AMAVILANH/DinaMonkey/Informe/simulaciones_fea.png

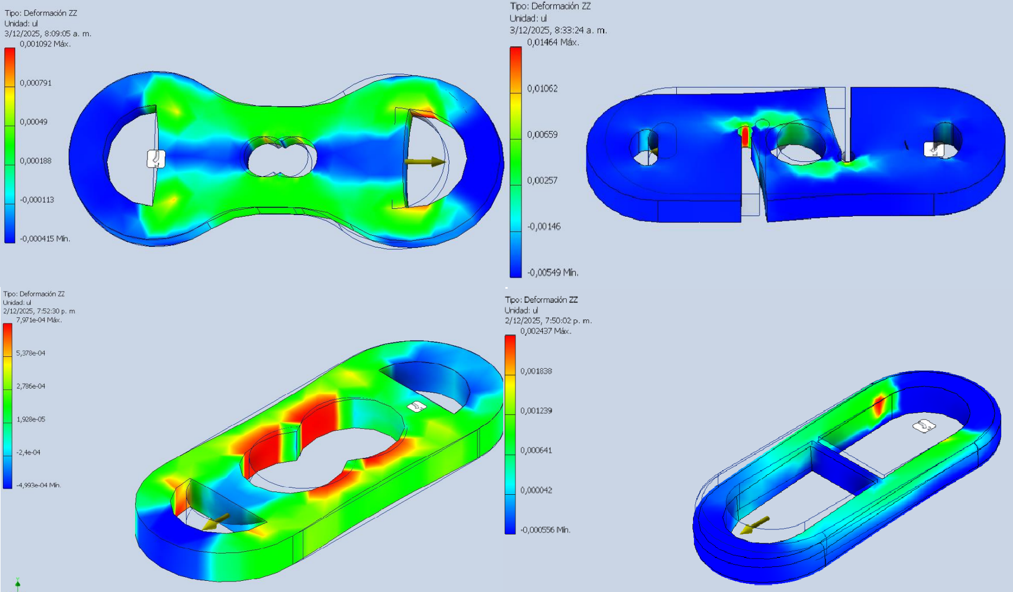
Informe/simulaciones_fea.png
