AMAVILANH/DinaMonkey/README.md

# DinaMonkey
Design and implementation of an embedded dynamometer using strain gauges for force measurement, amplification, digital acquisition, and experimental calibration.
