AMAVILANH/DinaMonkey/Dinamómetro_digital.pdf

Diseno e instrumentaci ˜ | on de un Dinam ´ | ometro ´

# digital para carga axial mediante galgas

| extensiometricas ´

Andres Mauricio Avilan Herrera ´
Facultad de Ingeniería
Depto. de Ing. Mecanica y Mecatr ´ | onica ´
Universidad Nacional de Colombia Bogota D.C., Colombia ´
amavilanh@unal.edu.co

Kennet Jared Cruz Machuca
Facultad de Ingeniería
Depto. de Ing. Mecanica y Mecatr ´ | onica ´
Universidad Nacional de Colombia Bogota D.C., Colombia ´
kcruzm@unal.edu.co
Abstract—Este documento presenta el diseno, construcci ˜ | on y ´
validacion de un sistema de medici ´ | on de fuerza axial de bajo ´
costo basado en galgas extensiometricas. El sistema utiliza dos ´ galgas OMEGA SGD-10/120-LY11 en configuracion de medio ´ puente de Wheatstone, acondicionadas mediante un convertidor analogico-digital de 24 bits (ADS1232) y procesadas por un ´
microcontrolador ESP32. La validacion experimental se realiz ´ | ó
en una maquina universal de ensayos Shimadzu, obteniendo ´
curvas de calibracion que relacionan la respuesta el ´ | ectrica digital ´
con la carga aplicada. El dispositivo permite la monitorizacion´
remota de fuerzas de tension y compresi ´ | on, ofreciendo una alter- ´
nativa accesible para aplicaciones de instrumentacion acad ´ | emica ´
e industrial.
Index Terms—Dinamometro, Galgas extensiom ´ | etricas, ESP32, ´
ADS1232, Instrumentacion, Calibraci ´ | on. ´
I. INTRODUCCION´

La medicion precisa de fuerzas axiales es fundamental en la ´ caracterizacion de materiales y el monitoreo de maquinaria y ´ aplicaciones industriales. Aunque las celdas de carga com-
erciales ofrecen alta precision, su integraci ´ | on en sistemas ´
personalizados o educativos a menudo requiere soluciones flexibles y de bajo costo.

Este proyecto aborda el desarrollo de un transductor de fuerza personalizado utilizando galgas extensiometricas de compor- ´ tamiento lineal (SGD-10/120-LY11). A diferencia de las soluciones comerciales de difícil acceso, este diseno implementa ˜ una arquitectura abierta basada en el microcontrolador ESP32, permitiendo no solo la adquisicion de datos mediante el ADC ´
ADS1232, sino tambien la transmisi ´ | on inal ´ | ambrica de datos ´
(IoT).

El objetivo principal es validar la linealidad y precision´
del sistema comparandolo con un patr ´ | on de referencia in- ´
dustrial (maquina Shimadzu), demostrando la viabilidad de ´ construir instrumentos de medida confiables con componentes electronicos accesibles. ´
II. DISENO DEL ˜ | SISTEMA DE MEDICION´
A. Requerimientos de Disenõ
El sistema fue disenado para medir fuerzas axiales de tensi ˜ | on´
en aplicaciones tipo slackline / highline, donde se requieren
altos margenes de seguridad mec ´ | anica, buena repetibilidad y ´
estabilidad frente a variaciones termicas y de montaje. El rango ´
objetivo de medicion se defini ´ | o entre ´ | 0.1 kN y 30 kN, con una
resolucion suficiente para detectar variaciones del orden de ´ decenas de Newtons.
B. Diseno Mec ˜ | anico del Elemento El ´ | astico ´

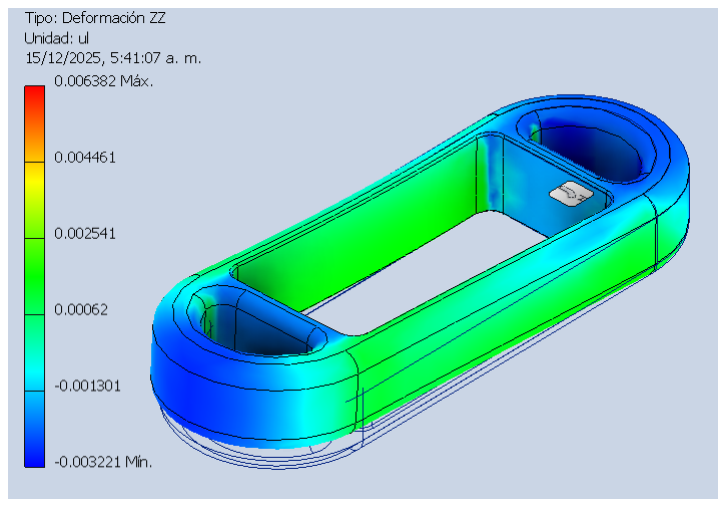
[picture p8: figure]

Fig. 1. Geometría de diseno seleccionado ˜

El elemento elastico del dinam ´ | ometro fue dise ´ | nado para operar ˜
bajo cargas axiales de tension dentro del r ´ | egimen estrictamente ´
elastico, garantizando repetibilidad, linealidad y seguridad es- ´ tructural. El material seleccionado fue aluminio serie 7075-T6, debido a su alta resistencia mecanica, bajo peso y estabilidad ´
elastica, con un m ´ | odulo de Young aproximado de ´ | E = 71 GPa
y un esfuerzo de fluencia superior a 500 MPa.
La seccion m ´ | ínima resistente del elemento se definio como ´
| A = 240 mm²
,

la cual corresponde a la zona instrumentada donde se instalaron las galgas extensiometricas. ´

1) Calculo Anal ´ | ítico de Esfuerzos y Deformaciones
Para una carga axial maxima de dise ´ | no de ˜ | Fmax = 30 kN, el
esfuerzo normal maximo se estim ´ | o mediante ´

σmax =

Fmax
A

,

obteniendose un valor aproximado de ´

σmax ≈ 125 MPa.

La deformacion unitaria axial correspondiente se calcul ´ | o a ´
partir de la ley de Hooke como

ϵmax =

σmax
E

,

resultando en una deformacion del orden de ´
ϵmax ≈ 1.76 × 10⁻³
(1760 µε).

Este nivel de deformacion se encuentra dentro del rango ´
optimo de operaci ´ | on de galgas extensiom ´ | etricas met ´ | alicas ´
convencionales, permitiendo una adecuada sensibilidad sin
riesgo de dano permanente ni p ˜ | erdida de linealidad. ´
2) Factor de Seguridad

El factor de seguridad frente a fluencia se estimo como ´

F S =

σfluencia

σmax

,

obteniendose un valor superior a ´

F S > 4,

lo cual resulta adecuado para aplicaciones de medicion en ´ sistemas sometidos a cargas variables y repetitivas, como en aplicaciones tipo slackline y ensayos experimentales.

3) Validacion mediante An ´ | alisis por Elementos Finitos ´

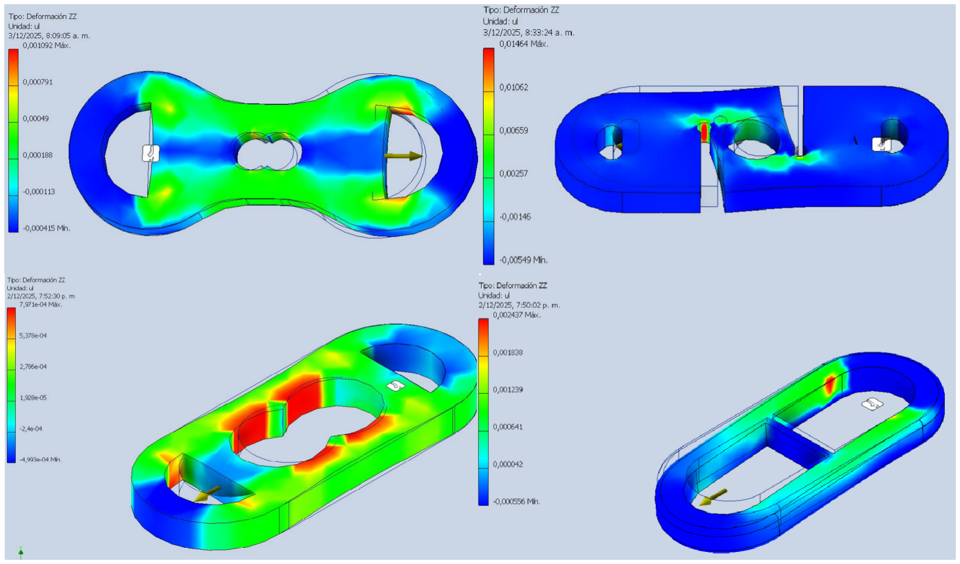
[picture p9: figure]

Fig. 2. Validacion mediante FEA

Se evaluaron multiples geometr ´ | ías del elemento elastico me- ´
diante analisis por elementos finitos (FEA), con el objetivo ´ de estudiar la distribucion de esfuerzos y deformaciones bajo ´ carga axial. Aunque algunas configuraciones presentaron may-
ores concentraciones locales de deformacion, estas geometr ´ | ías

reducían el margen de seguridad estructural y generaban regiones altamente sensibles a errores de posicionamiento de las galgas.

El diseno finalmente seleccionado prioriza una distribuci ˜ | on´
de deformacion m ´ | as uniforme a lo largo del brazo instru- ´
mentado, facilitando la instalacion reproducible de las galgas ´ y reduciendo la sensibilidad a desalineaciones y efectos de
borde. Esta geometría presento un compromiso ´ | optimo entre ´
sensibilidad, robustez mecanica y repetibilidad metrol ´ | ogica. ´
C. Seleccion y Configuraci ´ | on de Galgas Extensiom ´ | etricas ´

Se emplearon dos galgas lineales OMEGA SGD-10/120-LY11, de resistencia nominal R0 = 120 Ω y factor de galga GF ≈ 2.0, instaladas en configuracion de medio puente ´ de Wheatstone. Esta configuracion incrementa la sensibilidad ´ respecto a una galga simple y permite una compensacion´ parcial de los efectos termicos. ´

La variacion de resistencia de cada galga se modela como ´

| ∆R = R0 GF ϵ,

y la salida diferencial del medio puente se aproxima por

| Vout
| Vexc

≈

GF ϵ
2

D. Modelo Electrico del Puente ´
Con una tension de excitaci ´ | on´ | Vexc, la senal de salida del ˜
puente se encuentra en el orden de los microvoltios a milivoltios para el rango completo de carga, lo que impone requisitos estrictos sobre el sistema de adquisicion. ´
E. Seleccion del Convertidor Anal ´ | ogico-Digital ´
Para la digitalizacion de la se ´ | nal se seleccion ˜ | o el ADC ´
ADS1232 de Texas Instruments, un convertidor de 24 bits con amplificador de ganancia programable (PGA) integrado,
disenado espec ˜ | íficamente para sensores de puente resistivo.
La resolucion m ´ | ínima teorica del ADC viene dada por ´

LSB =

VFS
2

23 ,

donde VFS es el rango de entrada a la ganancia seleccionada. Aun considerando ruido y no idealidades, la resolucion efec- ´ tiva resultante es suficiente para discriminar las variaciones de deformacion producidas por incrementos de carga significati- ´
vamente menores al rango maximo, validando la selecci ´ | on del ´
ADS1232 para esta aplicacion. ´
La combinacion del dise ´ | no mec ˜ | anico, la configuraci ´ | on del ´
puente y la resolucion del ADC garantiza que el sistema pueda ´ medir fuerzas axiales con adecuada sensibilidad y estabilidad.

III. DISENO EL ˜ | ECTR ´ | ONICO ´
A. Implementacion Computacional ´
Para validar el diseno antes de la implementaci ˜ | on f ´ | ísica,
se realizo una simulaci ´ | on computacional utilizando MAT- ´
LAB/Python. El procedimiento consistio en: ´
- Iterar la carga aplicada F desde 0.5 kN hasta 5.0 kN.
- Resolver las ecuaciones gobernantes para cada paso de carga.
- Graficar las curvas de respuesta teorica para Defor- ´ macion, Voltaje del Puente y Salida del ADC. ´

Las curvas de caracterizacion resultantes se presentan en la ´ Figura 5.

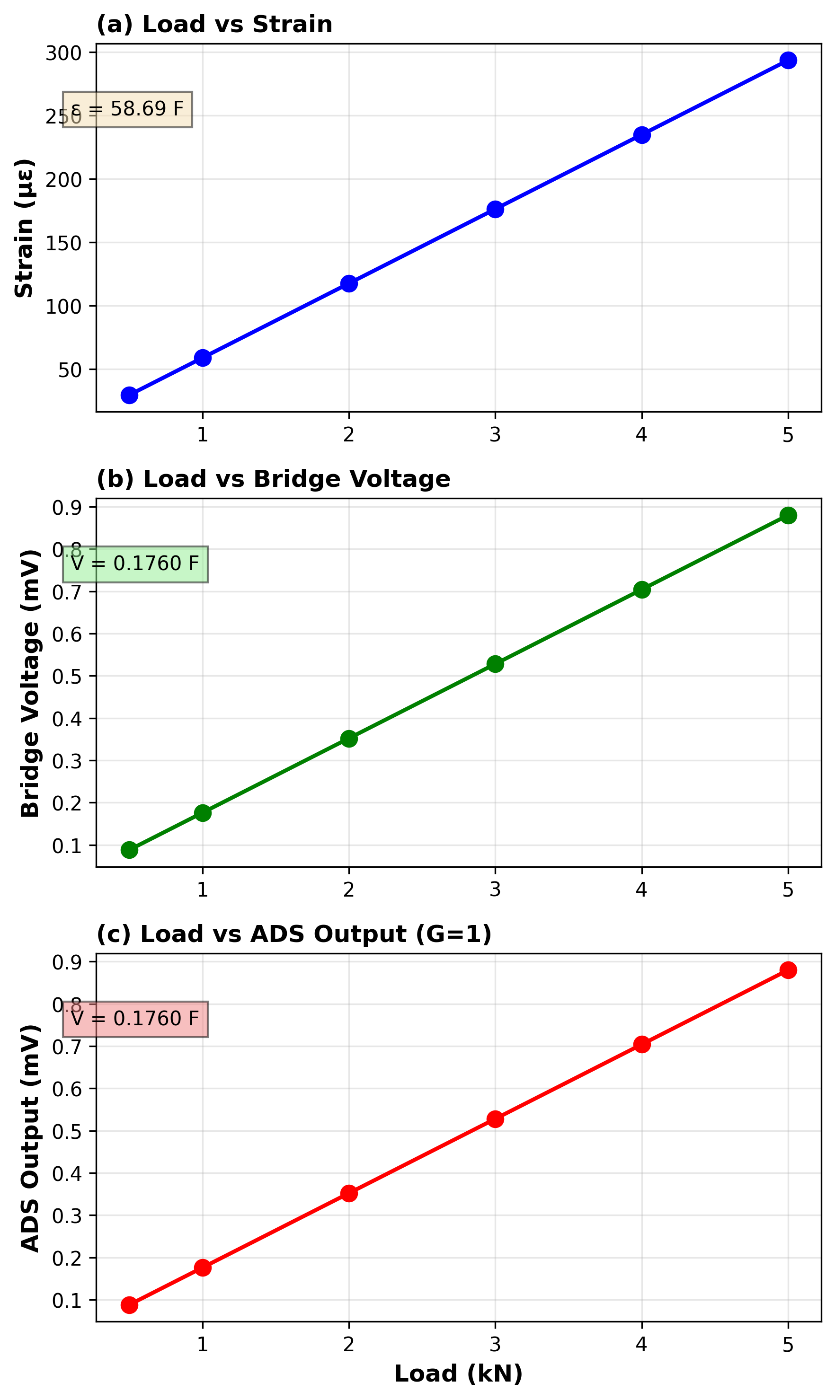
[picture p10: figure]

Fig. 3. Caracterizacion te ´ | orica del dinam ´ | ometro (Ganancia 1). Las gr ´ | aficas ´
muestran una linealidad perfecta (R² = 1.0) a traves de las tres etapas de ´
transduccion: Deformaci ´ | on Mec ´ | anica, Voltaje del Puente y Salida Final. ´

Como se observa en las graficas, el sistema exhibe una ´ respuesta perfectamente lineal. Sin embargo, debido a la
configuracion de Ganancia Unitaria ( ´ | | | G = 1), el voltaje de
salida maximo a ´ | 5 kN es de aproximadamente 0.88 mV, lo
cual confirma la necesidad de una etapa de filtrado de ruido
altamente efectiva en la implementacion f ´ | ísica.
Luego, se desarrollo un modelo te ´ | | orico de la cadena completa ´
Fuerza–Deformacion–Se ´ | nal el ˜ | ectrica, este modelo se imple- ´

mento en Simulink encadenando bloques que representan: la ´ fuerza aplicada, la ley de Hooke, la ecuacion de la galga, ´ el puente de Wheatstone y un amplificador operacional obteniendo así una estimacion te ´ orica del comportamiento de las ´ galgas.

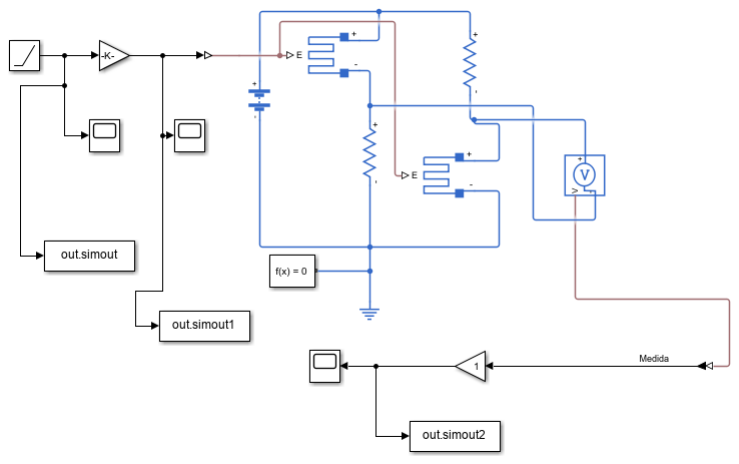
[picture p11: figure]

Fig. 4. Diagrama del sistema realizado en SimuLink

Al realizar la simulacion se obtienen las gr ´ | aficas a partir de ´
la visualizacion de los scopes y de los datos exportados al ´ workspace como se ve a continuacion: ´

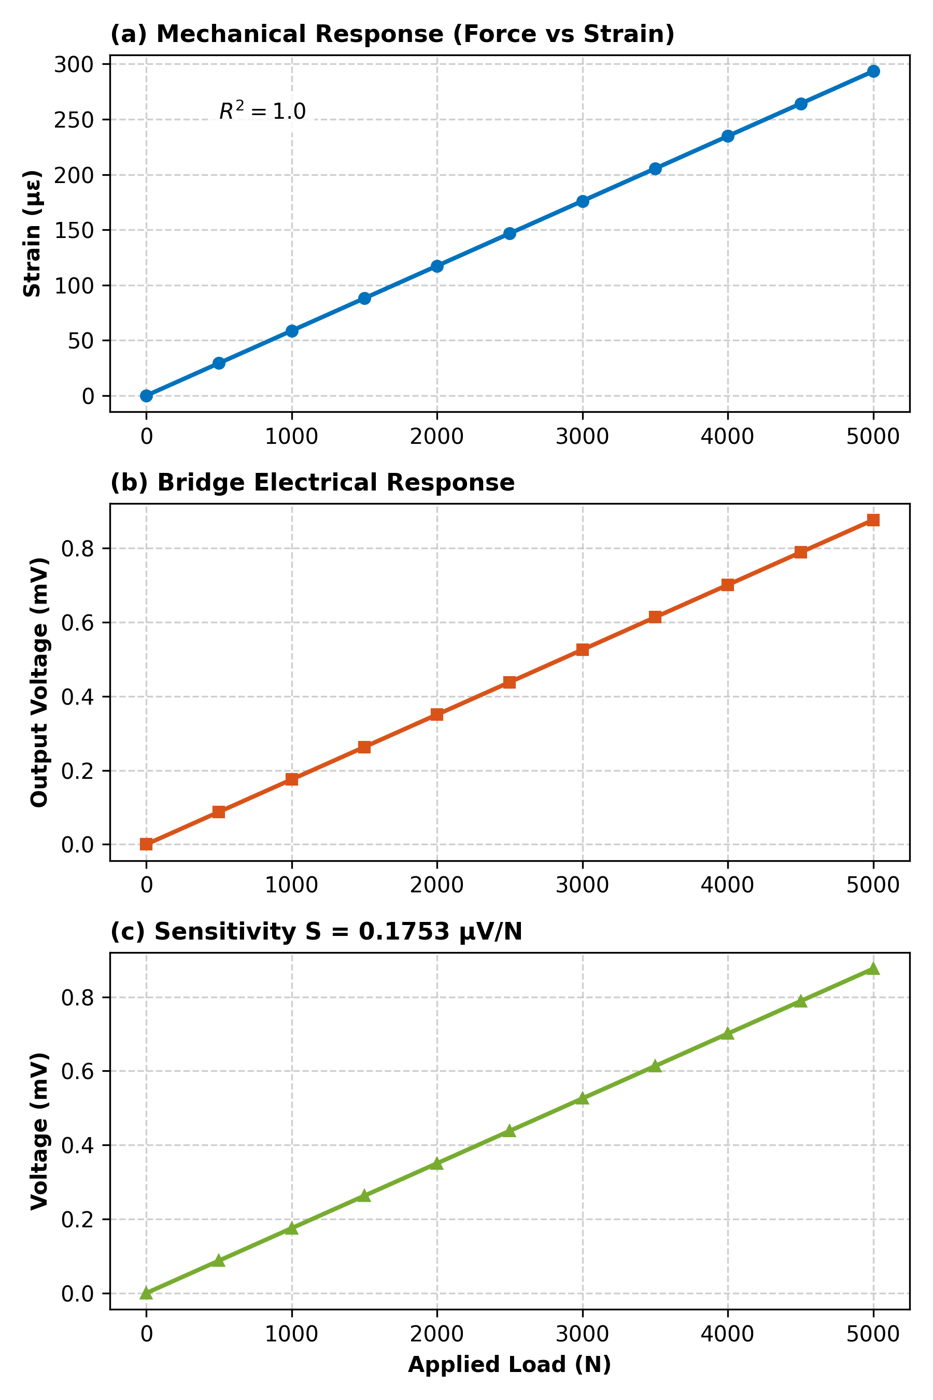
[picture p12: figure]

Fig. 5. Graficas obtenidas a partir de la simulaci ´ | on´
B. Acondicionamiento de Senal ˜
El acondicionamiento de la senal proveniente del puente exten- ˜
siometrico requiere un an ´ | alisis detallado del ancho de banda ´
efectivo del sistema de adquisicion, con el fin de garantizar ´

estabilidad, rechazo de ruido y correcta reconstruccion de la ´
senal de inter ˜ | es. ´
El convertidor analogico-digital seleccionado, ´ | ADS1232, in-
corpora un modulador Σ–∆ de segundo orden y un filtro digital de decimacion interno. De acuerdo con la hoja de ´ datos del fabricante, el ancho de banda efectivo del sistema se aproxima como
BWADS ≈ 0.26 · SP S | (1)

donde SP S corresponde a la tasa de muestreo configurada.

Para la configuracion utilizada en este proyecto ( ´ | SP S =
10 Hz), el ancho de banda efectivo resulta
BWADS ≈ 2.6 Hz | (2)

La Figura 6 presenta un diagrama simplificado de la arquitectura interna del ADS1232, destacando el amplificador de ganancia programable (PGA), el modulador Σ–∆ y el bloque de filtrado digital.

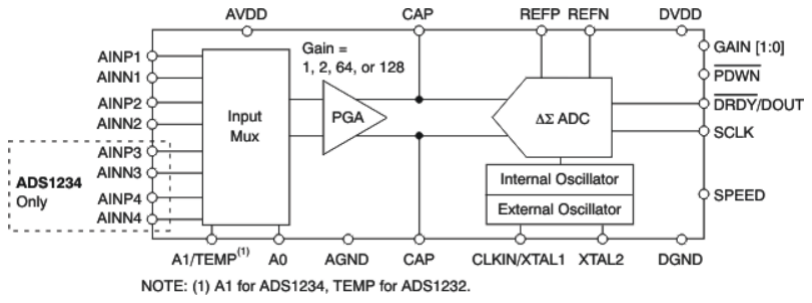
[picture p13: figure]

Fig. 6. Arquitectura simplificada del ADS1232

1) Simulacion Ideal del Puente Extensiom ´ | etrico ´
Inicialmente se realizo una simulaci ´ | on ideal del puente exten- ´
siometrico mediante an ´ | alisis de punto de operaci ´ | on ( ´ | .op) en
LTspice, parametrizando la carga aplicada en valores discretos de masa (kg). En esta condicion ideal, la salida diferencial del ´ puente presenta una relacion estrictamente lineal con la carga ´ aplicada, como se muestra en la Figura 7.

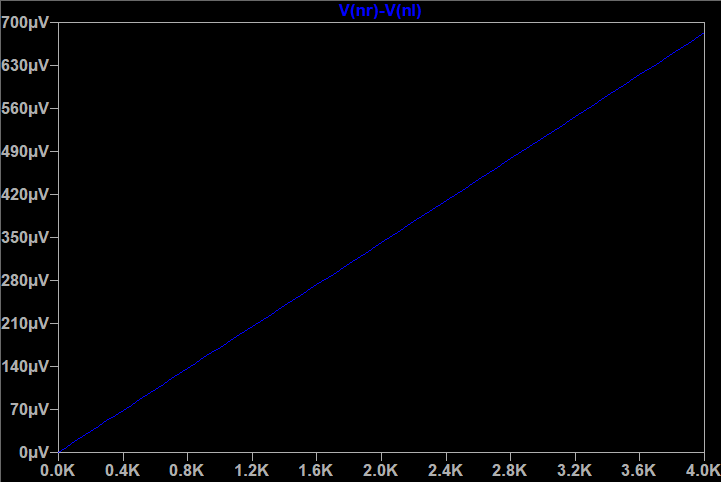
[picture p14: figure]

Fig. 7. Respuesta ideal del puente extensiometrico (simulaci ´ | on´ .op)

Este resultado confirma la linealidad teorica del sistema ´
fuerza–deformacion–se ´ | nal el ˜ | ectrica. Sin embargo, este esce- ´
nario no representa el comportamiento real del sistema, donde
estan presentes perturbaciones el ´ | ectricas y mec ´ | anicas. ´
2) Necesidad de Filtrado Analogico ´

Al introducir fuentes de ruido diferencial en la simulacion´
transitoria (.tran), se observa una superposicion de se ´ | nales ˜
de ruido sobre la salida diferencial del puente, degradando la estabilidad de la medicion. Aunque el filtrado digital del ´ ADS1232 atenua estas perturbaciones, resulta necesario im- ´ plementar un filtrado analogico previo que limite el ancho de ´
banda de la senal de entrada al PGA. Para este prop ˜ | osito se ´
disenõ un filtro RC diferencial de primer orden en las entradas ´ del ADC, como se muestra en la siguiente figura.

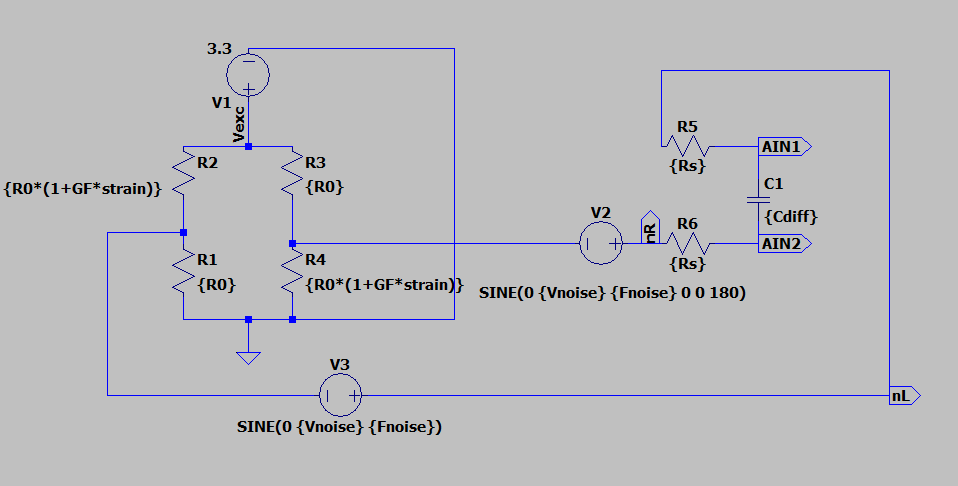
[picture p15: figure]

Fig. 8. Filtro RC diferencial en la entrada del ADS1232

3) Diseno del Filtro RC Diferencial ˜
El filtro esta compuesto por dos resistencias serie ´ | Rs y un
capacitor diferencial Cdiff, cuya frecuencia de corte se define como

fc =

1
2πRsCdiff
| (3)

Con el objetivo de atenuar perturbaciones por encima del an-
cho de banda util y preservar la se ´ | nal de inter ˜ | es, se seleccion ´ | ó
una frecuencia de corte cercana a 15 Hz. Para ello se adoptaron los valores:
Rs = 1 kΩ | (4)
Cdiff = 10 µF | (5)

Estos valores producen una atenuacion significativa de com- ´ ponentes por encima de 50 Hz, sin introducir distorsion apre- ´ ciable en la banda de interes. ´

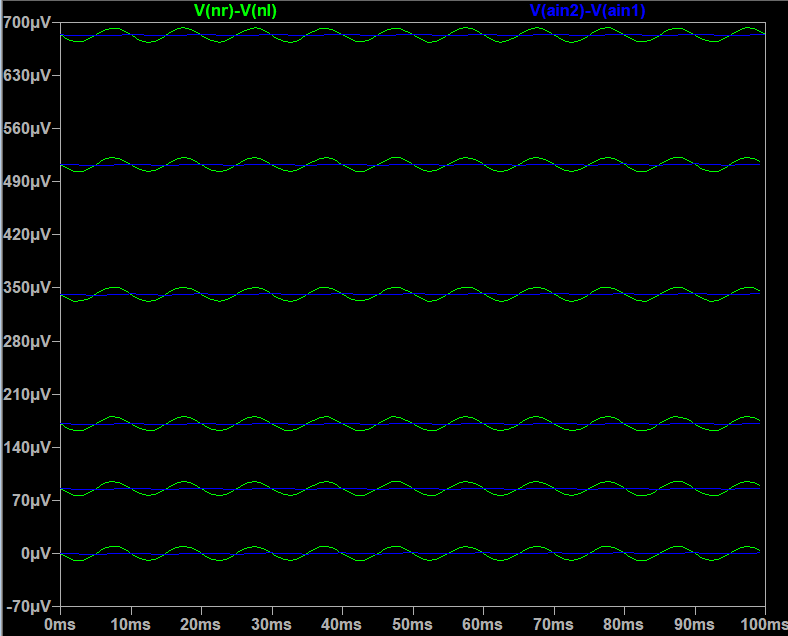
[picture p16: figure]

Fig. 9. Comparacion entre la se ´ | nal diferencial del puente extensom ˜ | etrico y ´
la senal diferencial en las entradas AIN del sistema de adquisici ˜ | on´
C. Adquisicion y Procesamiento ´
El ADS1232 es un convertidor analogico–digital ´ | Σ–∆ difer-
encial de 24 bits disenado para la lectura directa de puentes ˜ resistivos. En este trabajo, el dispositivo se utilizo para adquirir ´
la tension diferencial generada por un puente extensiom ´ | | etrico ´
sometido a carga mecanica. ´

El convertidor no mide fuerza ni voltaje absoluto, sino la diferencia de potencial entre las entradas AIN+ y AIN. Dicha diferencia se define como

VIN = VAIN+ − VAIN−, | (6)

la cual es escalada internamente por la ganancia programada (PGA) antes del proceso de cuantificacion. ´

Lectura digital (raw)

El valor digital leído desde el ADS1232, denominado raw, corresponde a un entero con signo representado en complemento a dos y codificado en 24 bits efectivos. Este valor es proporcional a la fraccion del rango de entrada del ADC y se ´ expresa matematicamente como ´

| raw =
VIN

VFS
2

23
, | (7)

donde VFS representa el rango de voltaje diferencial de plena escala del convertidor.

El uso del factor 2

23 se debe a que uno de los 24 bits disponibles esta reservado para el signo. En consecuencia, el ´
rango digital del dispositivo esta comprendido entre ´ | −2 23 y
2

23 − 1, siendo 0 el valor asociado a una entrada diferencial nula.

Rango de voltaje y resolucion´

El rango de entrada del ADS1232 depende de la tension´ de referencia y de la ganancia interna seleccionada. En este

trabajo se utilizo una tensi ´ | on de referencia ´ | VREF = 3.3 V y
una ganancia PGA igual a 1, por lo que el rango diferencial de entrada fue
| VFS = ±3.3 V. | (8)
Bajo esta configuracion, el tama ´ | no del bit menos significativo ˜
(LSB) viene dado por
| LSB =

VFS
2
23 , | (9)

lo que corresponde a una resolucion aproximada de ´

| LSB ≈ 0.393 µV. | (10)

En consecuencia, cada incremento unitario en el valor raw
representa una variacion de aproximadamente ´ | | 0.39 µV en la
entrada diferencial del ADC.

Proceso de adquisicion digital ´

La lectura del dato se realizo siguiendo el protocolo es- ´ pecificado en el datasheet del ADS1232. El sistema esperó a que la línea de datos (DOUT) indicara disponibilidad de conversion, tras lo cual se leyeron secuencialmente 24 bits, ´
correspondientes al codigo digital de la conversi ´ | | on. Posterior- ´
mente, se aplico un pulso adicional de reloj para finalizar la ´ transferencia.

Dado que el microcontrolador emplea variables de 32 bits con signo, fue necesario realizar una extension de signo para ´ interpretar correctamente los valores negativos, garantizando la coherencia del dato leído con el formato de complemento a dos del ADC.

Comportamiento del cero

Durante las pruebas experimentales se observo que, en ausen- ´ cia de carga, el valor raw no era exactamente nulo. Este comportamiento se atribuye a desbalances inherentes del puente extensiometrico, offsets internos del convertidor, efec- ´
tos termicos y ruido de baja frecuencia. Por esta raz ´ | | on, se ´
realizo un procedimiento de tara, consistente en calcular el ´ promedio de multiples muestras sin carga y restarlo posterior- ´ mente a las mediciones adquiridas bajo carga.

Consistencia experimental

Las variaciones observadas en el valor raw al aplicar cargas crecientes mostraron una relacion aproximadamente lineal con ´ la fuerza aplicada. Por ejemplo, una variacion de aproximada- ´ mente 600 cuentas digitales correspondio a un incremento de ´
tension diferencial del orden de ´ | | 236 µV, valor coherente con el
nivel de deformacion esperado en el elemento instrumentado ´
y con el modelo teorico del puente extensiom ´ | | etrico. ´

Seleccion de la ganancia ´

La configuracion con ganancia PGA = 1 proporcion ´ | | o una ´
mayor estabilidad del cero y una menor sensibilidad al ruido,
evitando la saturacion del convertidor. Aunque esta elecci ´ | | on´

reduce la resolucion te ´ orica del sistema, se obtuvo una res- ´ olucion efectiva suficiente para el rango de cargas analizado, ´ resultando adecuada para el ensayo experimental realizado.

IV. RESULTADOS EXPERIMENTALES Y CALIBRACION´

A. Descripcion del Ensayo ´
Para la caracterizacion del dinam ´ | ometro, se realizaron medi- ´
ciones de carga tanto en el proceso de carga como en el proceso de descarga. Se tomaron 6 valores durante la subida de la carga y 5 valores durante la bajada. Los puntos de medicion´ fueron los siguientes:

Carga (N): 0, 500, 1000, 2000, 3000, 4000, 3000, 2000, 1000, 500, 0

El objetivo de este procedimiento fue obtener una curva de calibracion precisa para correlacionar la lectura en *counts* ´
con las cargas aplicadas, considerando tanto la subida como la bajada de carga para identificar posibles histeresis y asegurar la fiabilidad de las mediciones.
El prototipo se observa a continuacion con la configuraci ´ | on´
del montaje:

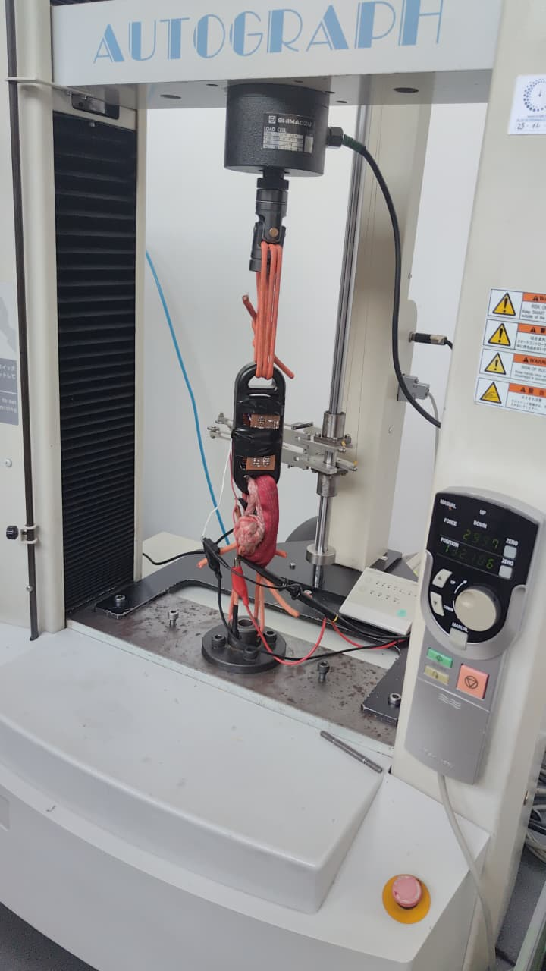
[picture p17: figure]

Fig. 10. | Prototipo experimental del dinamometro digital. Se observa el ´
elemento elastico instrumentado conectado al sistema de adquisici ´ | on de datos. ´
B. Datos Experimentales

A continuacion se presentan los datos experimentales ´ obtenidos durante las pruebas de carga:

LoadN | N samples | Mean (Raw) | Std (Raw)
0 500 1000 2000 3000 4000 | 27 30 30 30 30 30 | −24.37 485.1 949.23 1769 2640.9 3489.2 | 14.535 10.193 16.016 16.702 20.299 22.521
C. Sensibilidad por Segmento

La sensibilidad de los diferentes segmentos de carga es la siguiente:

Segment | Counts per N | N per count
0 − 500 500 − 1000 1000 − 2000 2000 − 3000 3000 − 4000 | 1.0189 0.92827 0.81973 0.87197 0.8483 | 0.98141 1.0773 1.2199 1.1468 1.1788
D. Precision´

Las desviaciones estandar convertidas en Newtons para cada ´ carga son las siguientes:

LoadN | Std (counts) | Std (N)
0 500 1000 2000 3000 4000 | 14.535 10.193 16.016 16.702 20.299 22.521 | 14.265 10.98 19.538 19.155 23.929 26.548
E. Calibracion Global ´
La ecuacion de calibraci ´ | on global obtenida es: ´

Counts = 0.868929 · N + 30.890

R

2 = 0.999309

F. Graficas de Resultados ´
A continuacion se presentan las gr ´ | aficas generadas a partir de ´
los datos experimentales y la calibracion: ´

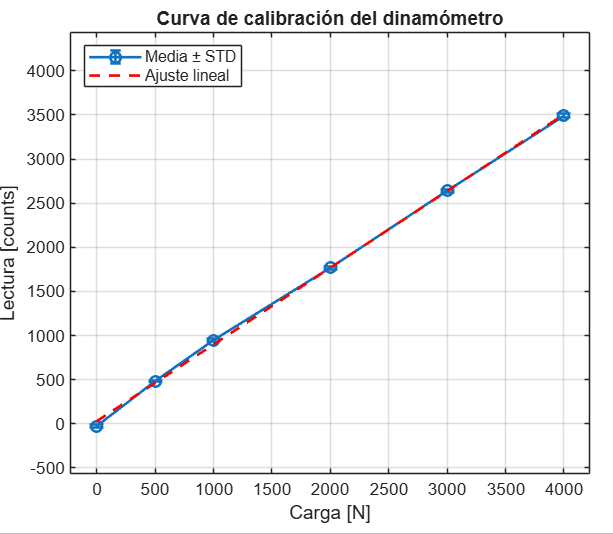
[picture p18: figure]

Fig. 11. Curva de calibracion del dinam ´ | ometro: Media ± STD con ajuste ´
lineal.

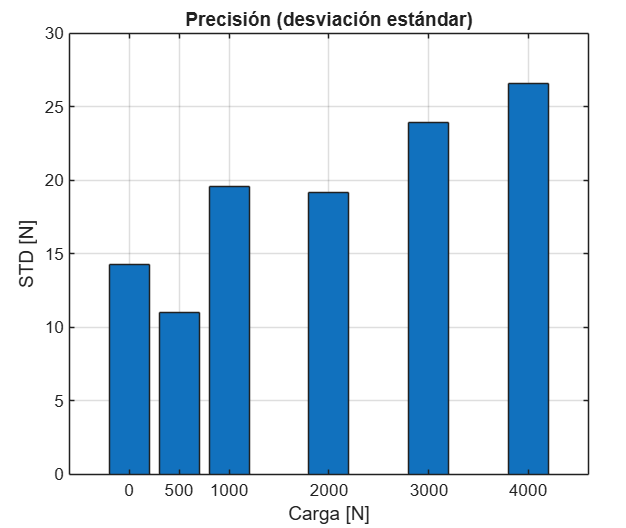
[picture p19: figure]

Fig. 12. Precision (desviaci ´ | on est ´ | andar) en funci ´ | on de la carga. ´

La siguiente grafica resume las mediciones obtenidas durante ´ el ciclo de prueba con el multímetro:

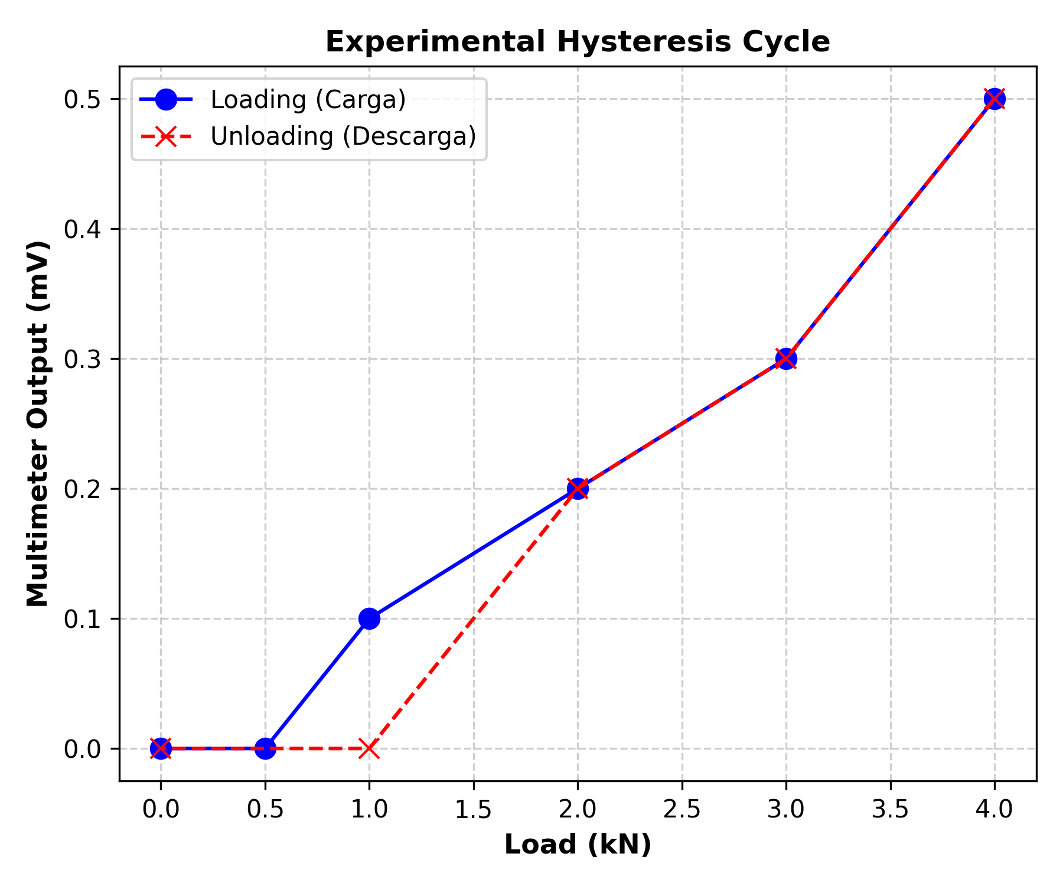
[picture p20: figure]

Fig. 13. | Curva de Histeresis Experimental tomada con mult ´ | ímetro. La
superposicion entre los puntos de carga (azul) y descarga (rojo) demuestra ´
la ausencia de histeresis mec ´ | anica significativa. ´

Los resultados experimentales muestran una salida maxima de ´ 0.5 mV a 4 kN, lo que corresponde a una sensibilidad aproximada de 0.125 mV/kN. Este valor es ligeramente inferior a
la prediccion te ´ | orica ( ´ | 0.176 mV/kN), probablemente debido a
perdidas resistivas en el cableado o alineaciones menores en ´ la instalacion de las galgas. ´

Sin embargo, el sistema exhibe una buena reversibilidad, con valores identicos durante las fases de carga y descarga ´ (histeresis ´ ≈ 0), confirmando el comportamiento elastico del ´ elemento de aluminio y la fiabilidad del proceso de pegado.

G. Capacidad IoT y Monitoreo Remoto
El sistema fue equipado con conectividad WiFi mediante el ESP32, permitiendo la transmision en tiempo real de medi- ´ ciones hacia la plataforma Blynk. Esto facilita el monitoreo
remoto, el registro historico de datos y la integraci ´ | on futura ´
con sistemas de automatizacion industrial. ´
V. CONCLUSIONES
Se disenõ, construy ´ | o y valid ´ | o un dinam ´ | ometro digital de bajo ´
costo para medicion de carga axial, integrando un elemento ´ elastico de aluminio 7075-T6 instrumentado con galgas ex- ´
tensiometricas en configuraci ´ | | on de medio puente diagonal. ´
El analisis experimental demostr ´ | o una buena linealidad en la ´
respuesta del sistema, en el rango de 1 a 4 kN, validando el
diseno mec ˜ | anico y la selecci ´ | on del material dentro de su zona ´
elastica. La ausencia de hist ´ | | eresis apreciable en las mediciones ´
directas de voltaje confirma la calidad de la adhesion de las ´ galgas y la estabilidad mecanica del transductor. ´

Sin embargo, se observo una discrepancia en la sensibilidad ´ del sistema. Mientras el modelo teorico predijo una sensibil- ´ idad de 0.176 mV/kN, las mediciones experimentales arrojaron un valor aproximado de 0.125 mV/kN. Esta atenuacion´ del 29% se atribuye principalmente a perdidas resistivas en ´ el cableado de interconexion y al efecto de carga del circuito ´ de acondicionamiento sobre la alta impedancia de salida del puente.

La implementacion con el ADC ADS1232 en configuraci ´ | on´
de ganancia unitaria (G = 1) permitio una adquisici ´ | on estable ´
con una resolucion efectiva adecuada para la aplicaci ´ | on. No ´
obstante, para futuras iteraciones se recomienda implementar
una etapa de pre-amplificacion de instrumentaci ´ | on con bajo ´
ruido o configurar la ganancia interna del ADC en G = 64, lo cual permitiría aprovechar mejor el rango del convertidor y aumentar la resolucion efectiva del sistema. ´
| | REFERENCES
[1] F. P. Beer, E. R. Johnston, J. T. DeWolf, and D. F. Mazurek, Mechanics of Materials, 6th ed. New York, NY, USA: McGraw-Hill Education, 2012.
[2] Texas Instruments, “ADS1232/ADS1234: 24-Bit, 80SPS, 2-Ch (Differential), Pin-Programmable Delta-Sigma ADC for Bridge Sensors,” SBAS350F Datasheet, Oct. 2004 [Revised Feb. 2008].
[3] OMEGA Engineering, “Linear Strain Gauges: SGD Series,” Technical Reference SGD-10/120-LY11, Norwalk, CT, USA, 2024.

[4] K. B. Klaassen, Electronic Measurement and Instrumentation. Cambridge, U.K.: Cambridge University Press, 1996, pp. 145–170.
[5] ASTM International, “Standard Specification for Aluminum and Aluminum-Alloy Drawn Seamless Tubes,” ASTM B210, West Conshohocken, PA, 2019.
[6] R. Pallas-Areny and J. G. Webster, ´ | Sensors and Signal Conditioning,
2nd ed. New York, NY, USA: John Wiley & Sons, 2001.
