AMAVILANH/DinaMonkey/simulaciones.pdf

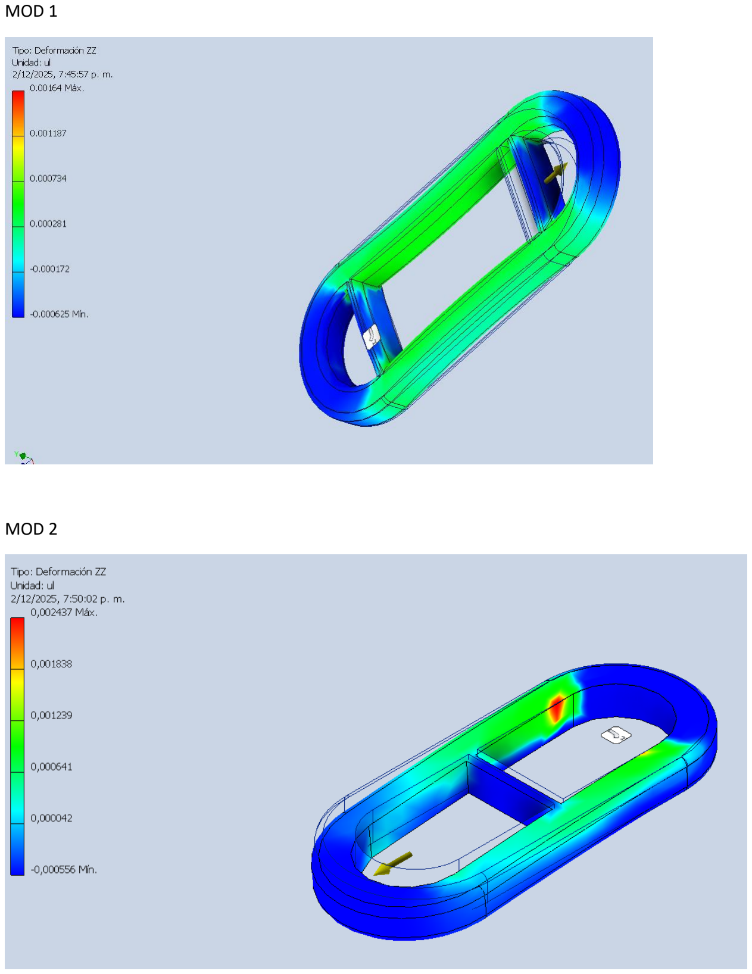
[picture p22: page 1]

MOD 1

MOD 2

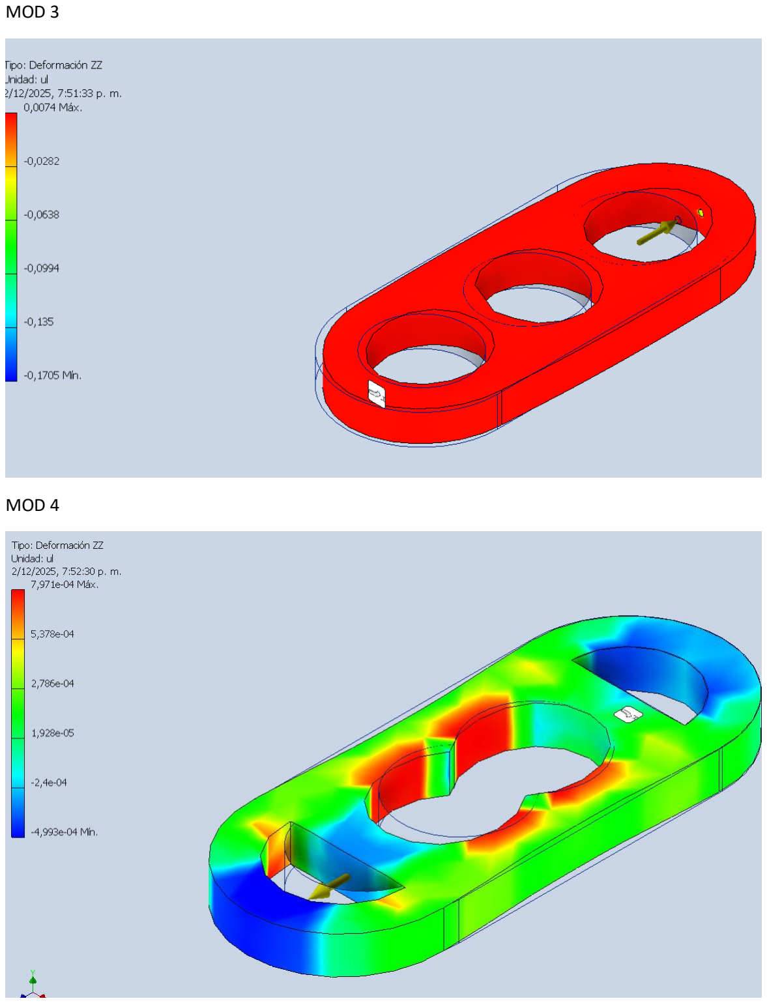
[picture p23: page 2]

MOD 3

MOD 4
