AMAVILANH/DinaMonkey/Inventor/caja_inferior.stl

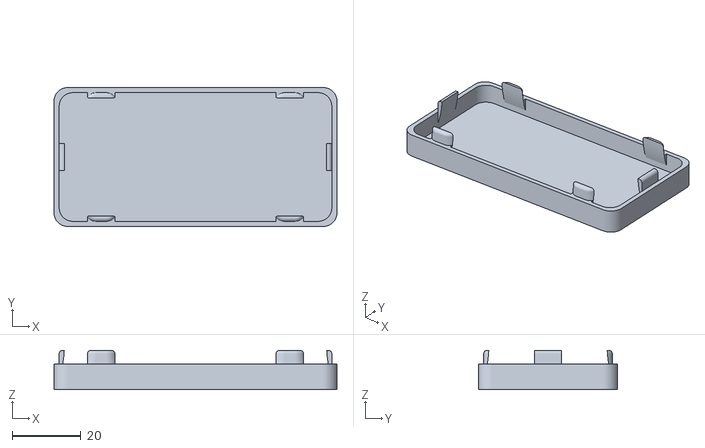
[picture p24: CAD file, 2025-12-15]
Inventor/caja_inferior.stl
82.5 x 40.5 x 11.5
