AMAVILANH/DinaMonkey/Inventor/caja_superior.stl

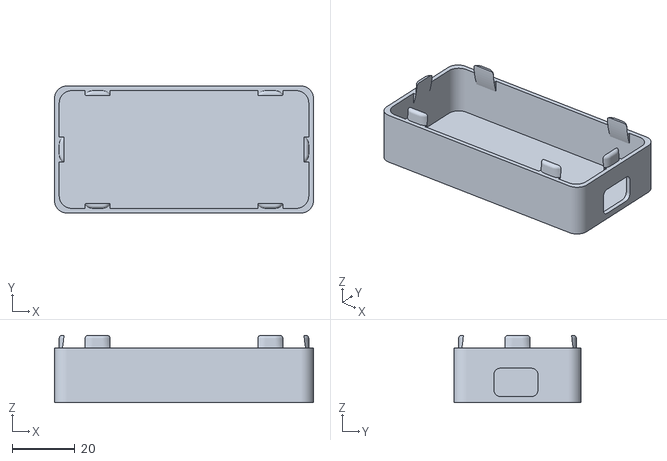
[picture p25: CAD file, 2025-12-15]
Inventor/caja_superior.stl
82.5 x 40.5 x 21.5
