AMAVILANH/DinaMonkey/Inventor/mod1.stp

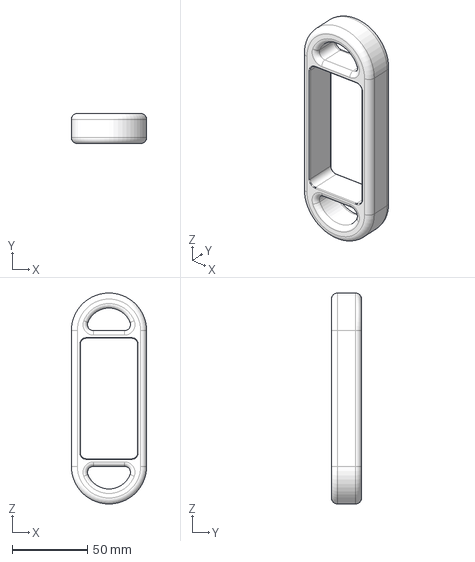
[picture p26: CAD file, 2025-12-13]
Inventor/mod1.stp
50.0 x 20.0 x 140.0 mm
