AMAVILANH/DinaMonkey/(list of files, cad)

Other CAD files:
Inventor/OldVersions/caja_inferior.0002.ipt
Inventor/OldVersions/caja_superior.0005.ipt
Inventor/OldVersions/cuerpo.0003.ipt
Inventor/OldVersions/mod1.0021.ipt
Inventor/OldVersions/mod2.0007.ipt
Inventor/OldVersions/mod3.0016.ipt
Inventor/OldVersions/mod4.0005.ipt
Inventor/OldVersions/mod5.0009.ipt
Inventor/OldVersions/mod6.0004.ipt
Inventor/OldVersions/modelado.0002.ipt
Inventor/caja_inferior.ipt
Inventor/caja_superior.ipt
Inventor/cuerpo.ipt
Inventor/mod1.ipt
Inventor/mod1.stl
Inventor/mod2.ipt
Inventor/mod3.ipt
Inventor/mod4.ipt
Inventor/mod5.ipt
Inventor/mod6.ipt
Inventor/modelado.ipt
