AMAVILANH/DinaMonkey/Simulaciones/Electrica/puente_calibrado.asc

C1: cap; {Cdiff}
R1: res; {R0}
R2: res; {R0*(1+GF*strain)}
R3: res; {R0}
R4: res; {R0*(1+GF*strain)}
R5: res; {Rs}
R6: res; {Rs}
V1: voltage; 3.3
V2: voltage; SINE(0 {Vnoise} {Fnoise} 0 0 180)
V3: voltage; SINE(0 {Vnoise} {Fnoise})
Named nets: 0, Vexc, nL, nR, AIN1, AIN2
* Parámetros generales
.param R0=120             ; resistencia nominal galga [ohm]
.param GF=2               ; gauge factor
.param Vexc=3.3             ; excitación del puente usada en el ensayo [V]
.param Gain=1             ; PGA efectivo usado en el ensayo (1)
.param eps_per_N=5.1793e-8   ; deformación por Newton (ajustada para counts/N=0.868929)
.param eps_per_kg = {eps_per_N*9.81} ; por si quieres usar kg
.param LSB = {Vexc/(8388608*Gain)}  ; voltios por conteo (2^23 convention)
.param Rs = 1k            ; R serie (filtrado)
.param Cdiff = 10u        ; C diferencial (filtrado)
 
.param strain = { N * eps_per_N }
 
* Parámetros de ruido
.param Vnoise=5u     
.param Fnoise=100
.tran 0 0.1 0 1u
.step param N list 0 500 1000 2000 3000 4000
