AMAVILANH/DinaMonkey/Simulaciones/Electrica/puente.asc

C1: cap; {Cdiff}
R1: res; {R0}
R2: res; {R0*(1+GF*strain)}
R3: res; {R0}
R4: res; {R0*(1+GF*strain)}
R5: res; {Rs}
R6: res; {Rs}
V1: voltage; 3.3
V2: voltage; SINE(0 {Vnoise} {Fnoise} 0 0 180)
V3: voltage; SINE(0 {Vnoise} {Fnoise})
Named nets: 0, Vexc, nL, nR, AIN1, AIN2
* Parámetros generales
.param R0=120 GF=2 eps_per_kg=5.70e-7 Vexc=3.3 Rs=1K Cdiff=10u Rref=1Meg GAIN=1
.param kg=0
.param strain={kg*eps_per_kg}
.param LSB={Vexc/8388608/Gain}
 
* Parámetros de ruido
.param Vnoise=5u     
.param Fnoise=100
.tran 0 0.02 0 1u
.step param kg list 0 1 5 10 20 66
