AMAVILANH/DinaMonkey/(list of files, drawings)

Other design files:
Simulaciones/Electrica/dinamometro.pdsprj
Simulaciones/Electrica/Project Backups/dinamometro [20251213, 17-14-01].pdsprj
Simulaciones/Electrica/Project Backups/dinamometro [20251213, 17-14-03].pdsprj
Simulaciones/Electrica/Project Backups/dinamometro [20251213, 17-22-39].pdsprj
Simulaciones/Electrica/Project Backups/dinamometro [20251213, 17-29-06].pdsprj
Simulaciones/Electrica/Project Backups/dinamometro [20251213, 17-36-19].pdsprj
Simulaciones/Electrica/Project Backups/dinamometro [20251213, 17-44-53].pdsprj
