AMAVILANH/DinaMonkey/(commit log)

2025-12-13 Initian commit
    [cuerpo.0003.ipt, cuerpo.ipt, dinamometro.pdsprj, mod1.0020.ipt, mod1.ipt, mod1.stl, mod1.stp, mod2.0007.ipt]
2025-12-13 Calculo de sensibilidad
2025-12-15 full ADS1232 acquisition with tare and kN calibration with IoT interface
    [caja_inferior.0002.ipt, caja_inferior.ipt, caja_inferior.stl, caja_superior.0005.ipt, caja_superior.ipt, caja_superior.stl, dinamometro [20251213, 17-14-01].pdsprj, dinamometro [20251213, 17-14-03].pdsprj]
